HMSteve/HB-UNI-Sen-CO2_v2/PCB/SCD41_Breakout_v1_TopPlace.pdf

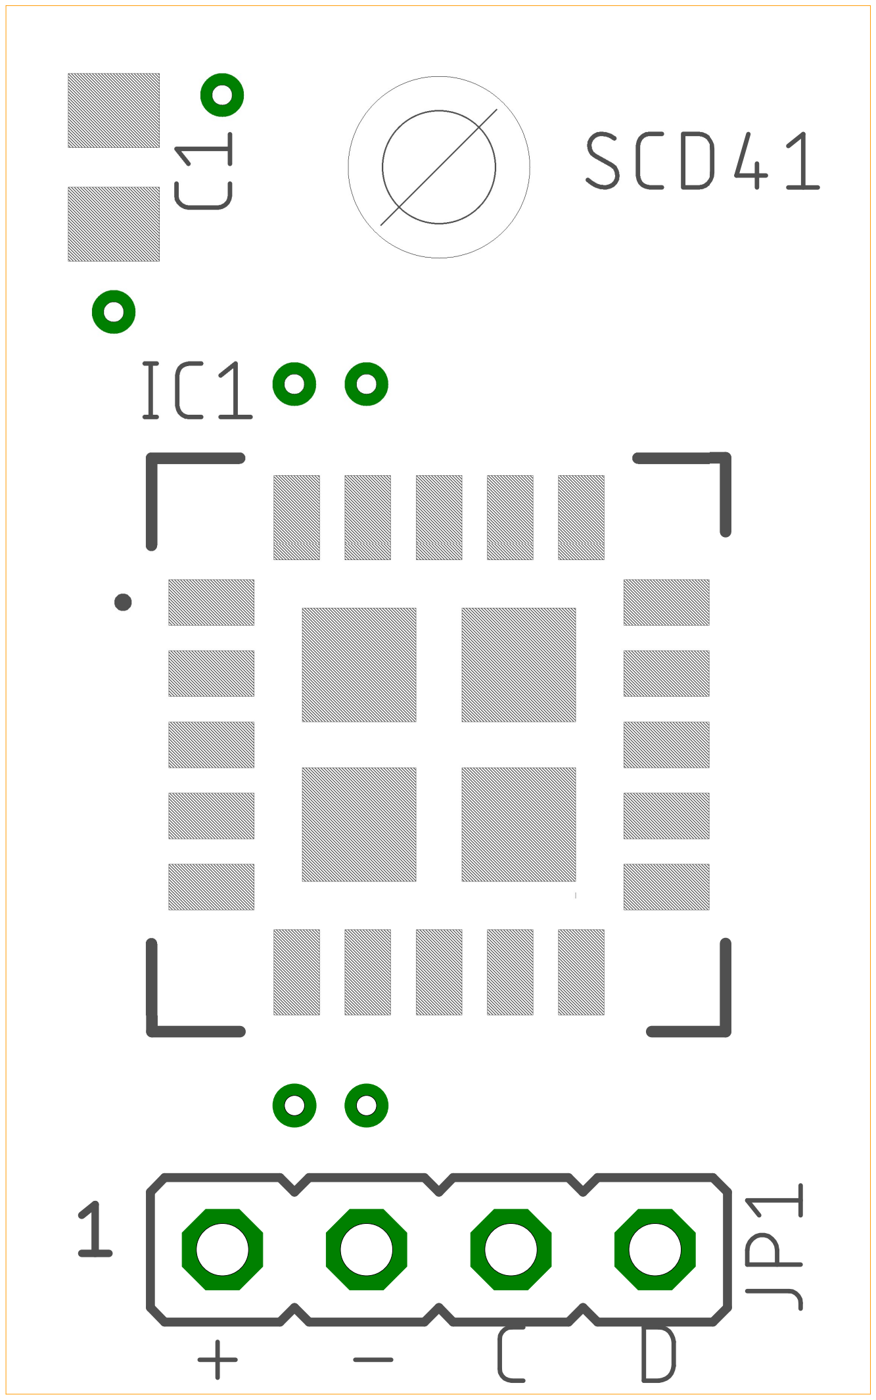
[picture p3: figure]
