HMSteve/HB-UNI-Sen-CO2_v2/PCB/HB-Uni-Sen-CO2_v2p1_Schematic.pdf

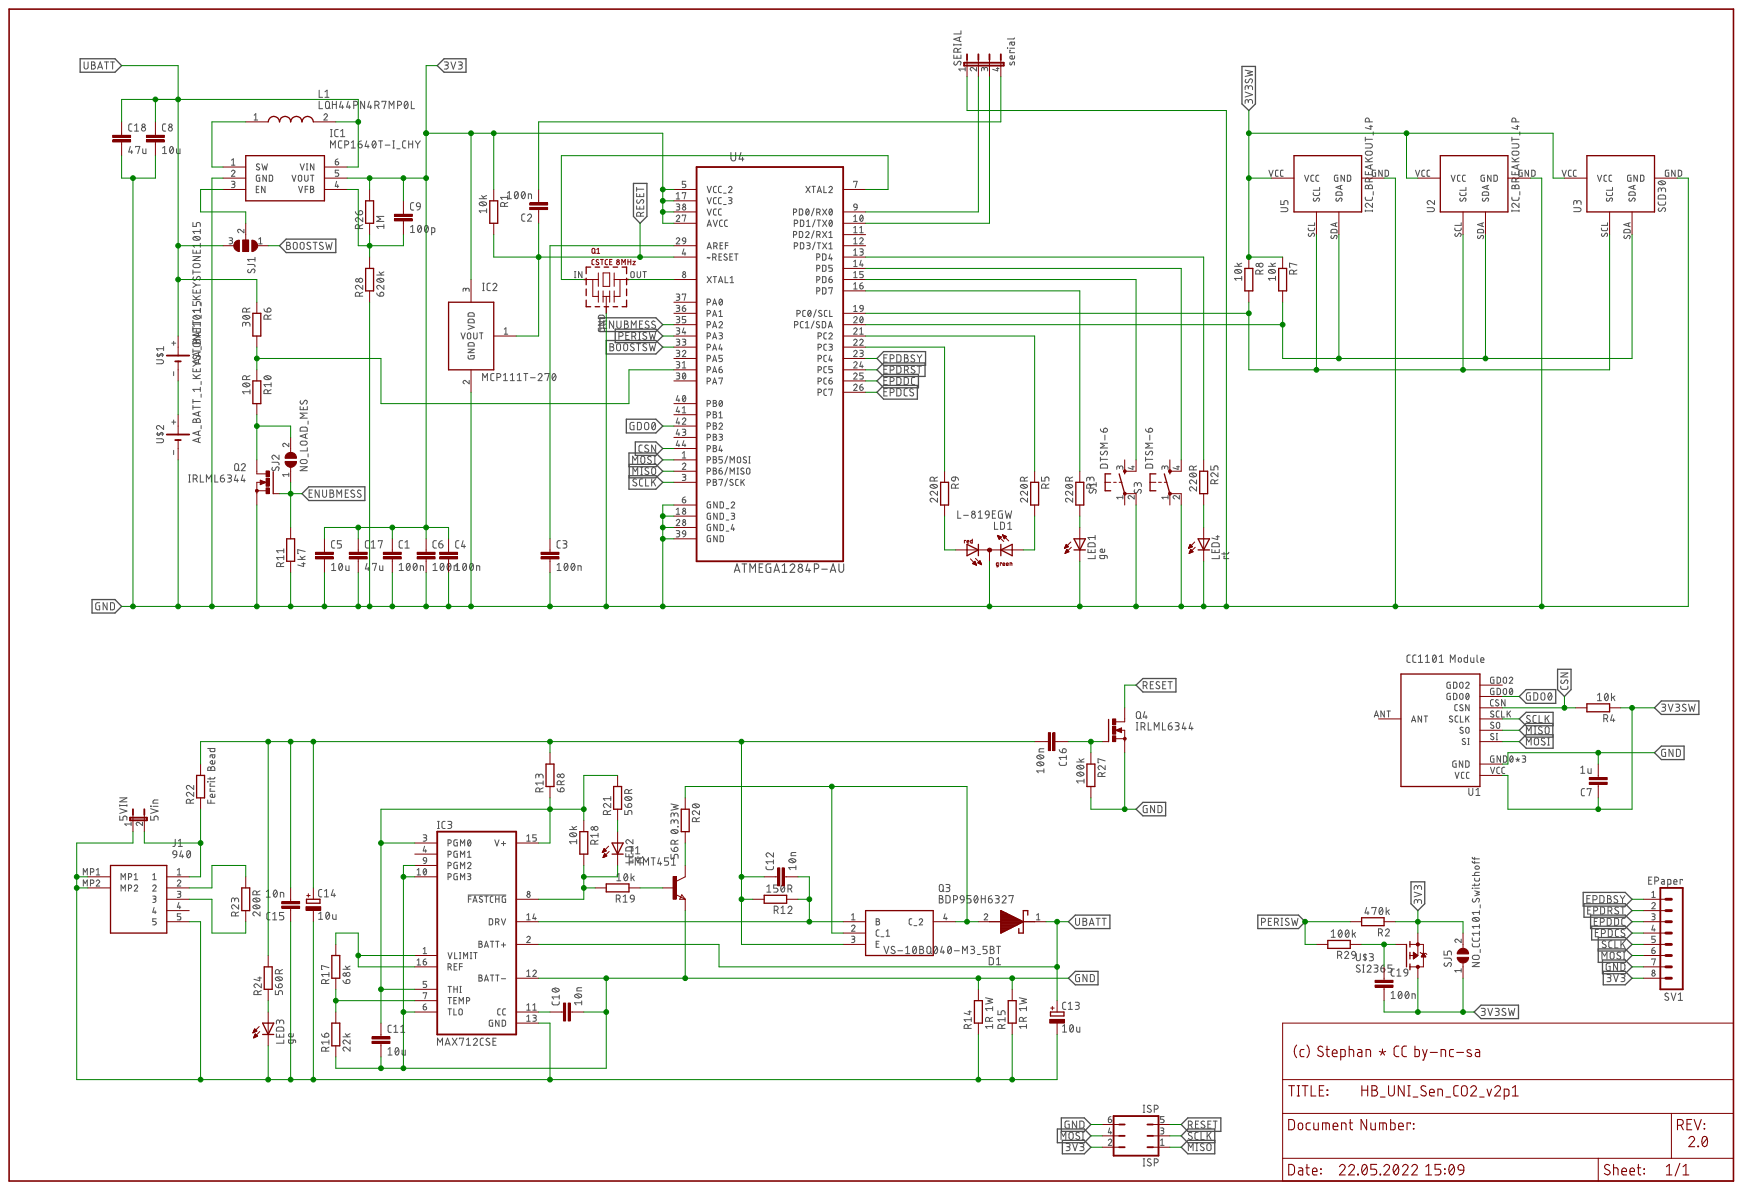
[picture p4: page 1]
