HMSteve/HB-UNI-Sen-CO2_v2/PCB/HB-Uni-Sen-CO2_v2_Schematic.pdf

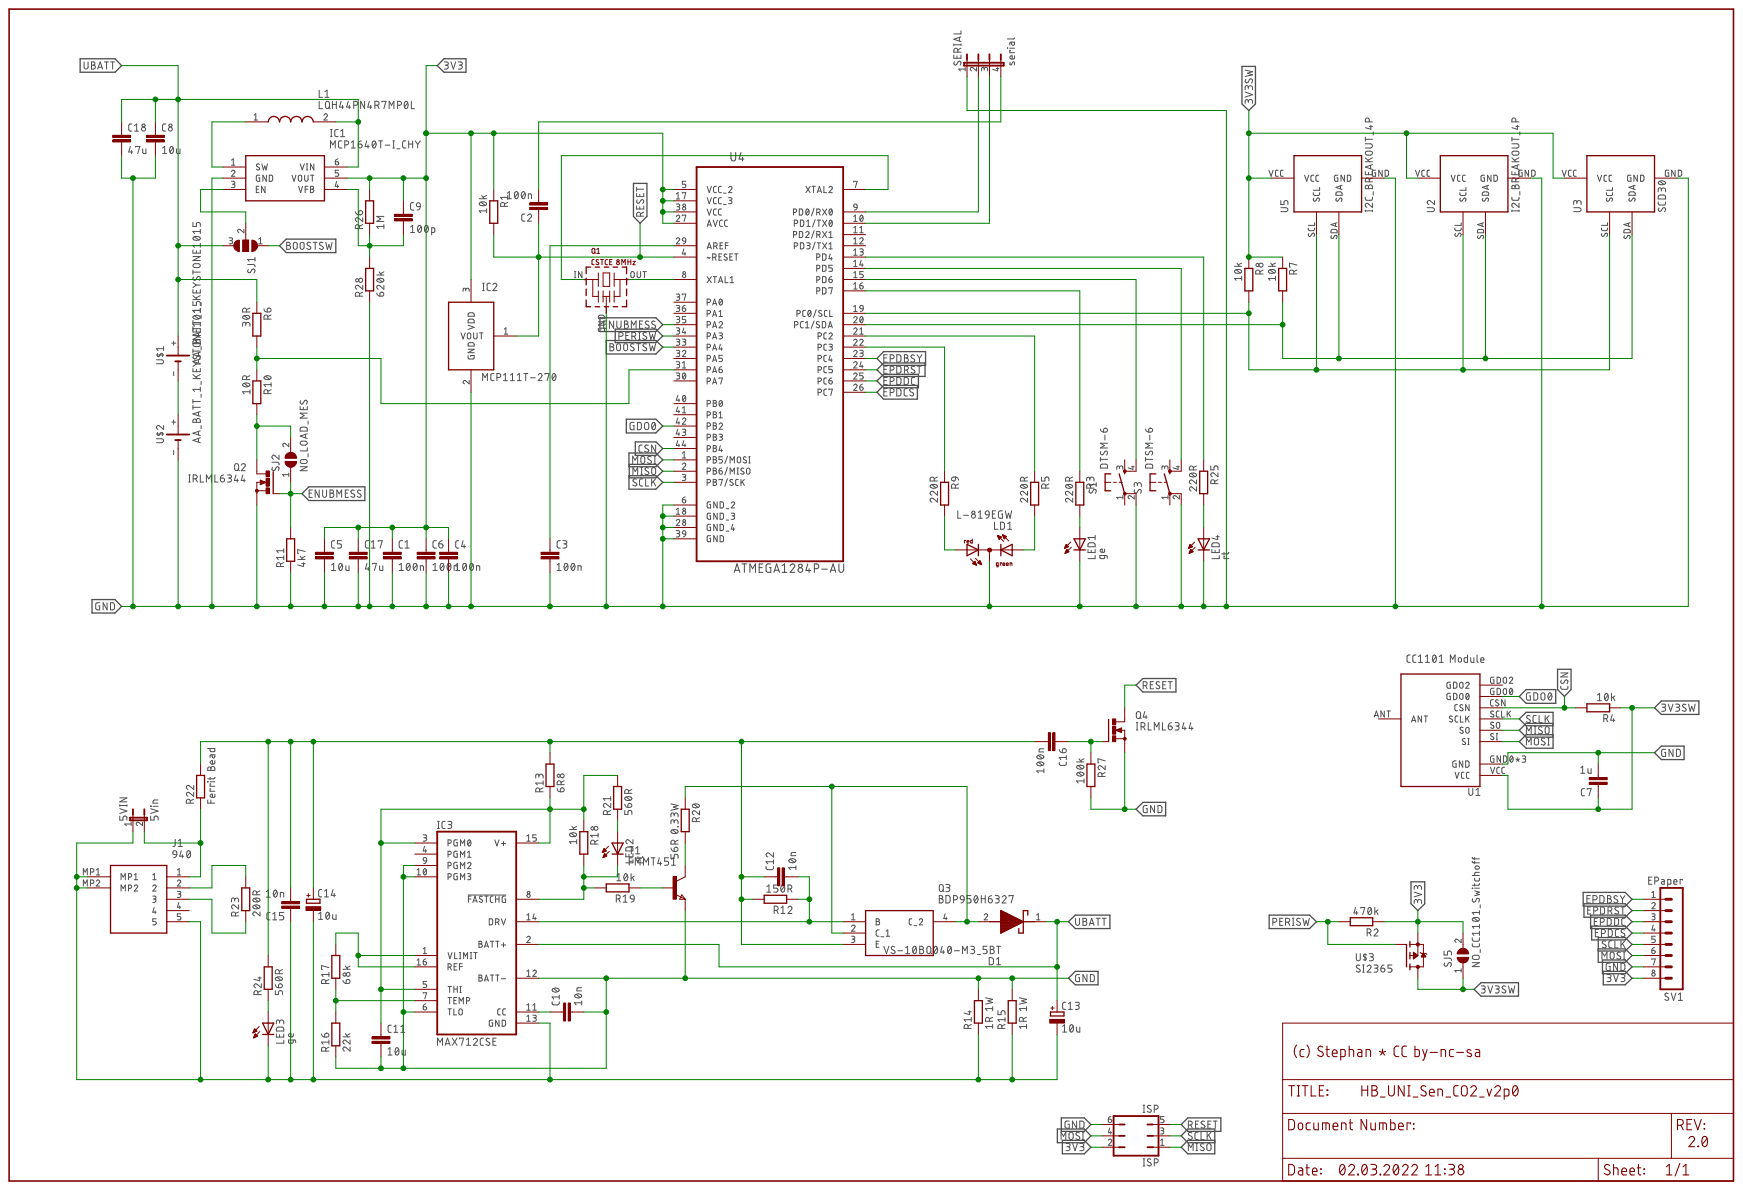
[picture p5: page 1]
