HMSteve/HB-UNI-Sen-CO2_v2/PCB/SCD41_Breakout_v1_BottomPlace.pdf

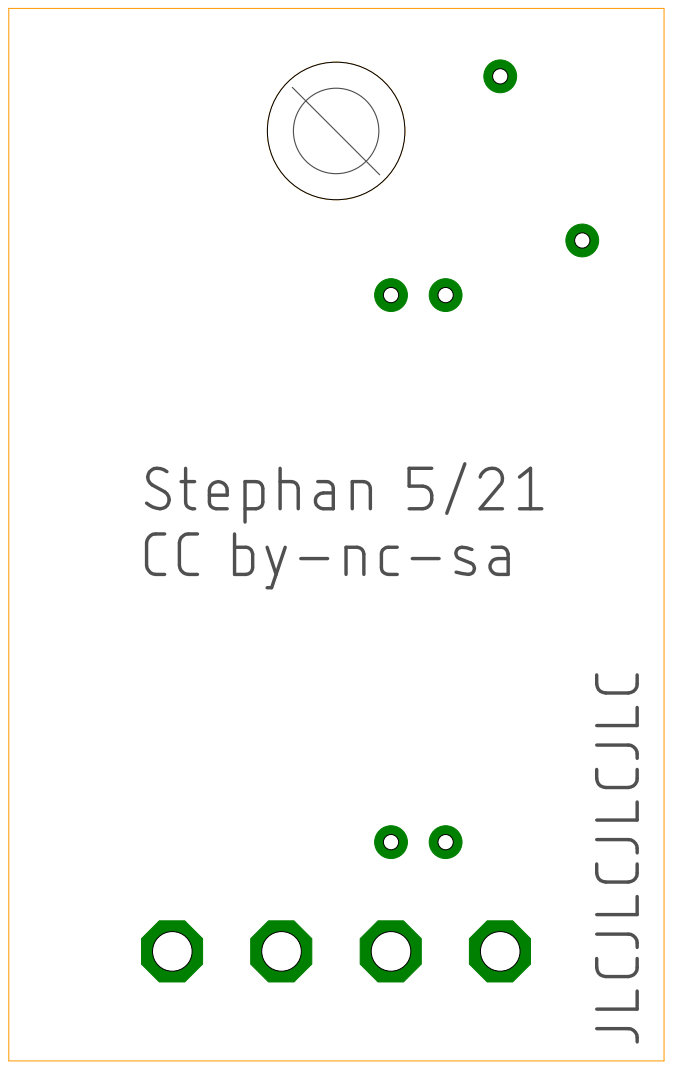
[picture p6: page 1]
