HMSteve/HB-UNI-Sen-CO2_v2/PCB/HB-Uni-Sen-CO2_v2_BottomPlace.pdf

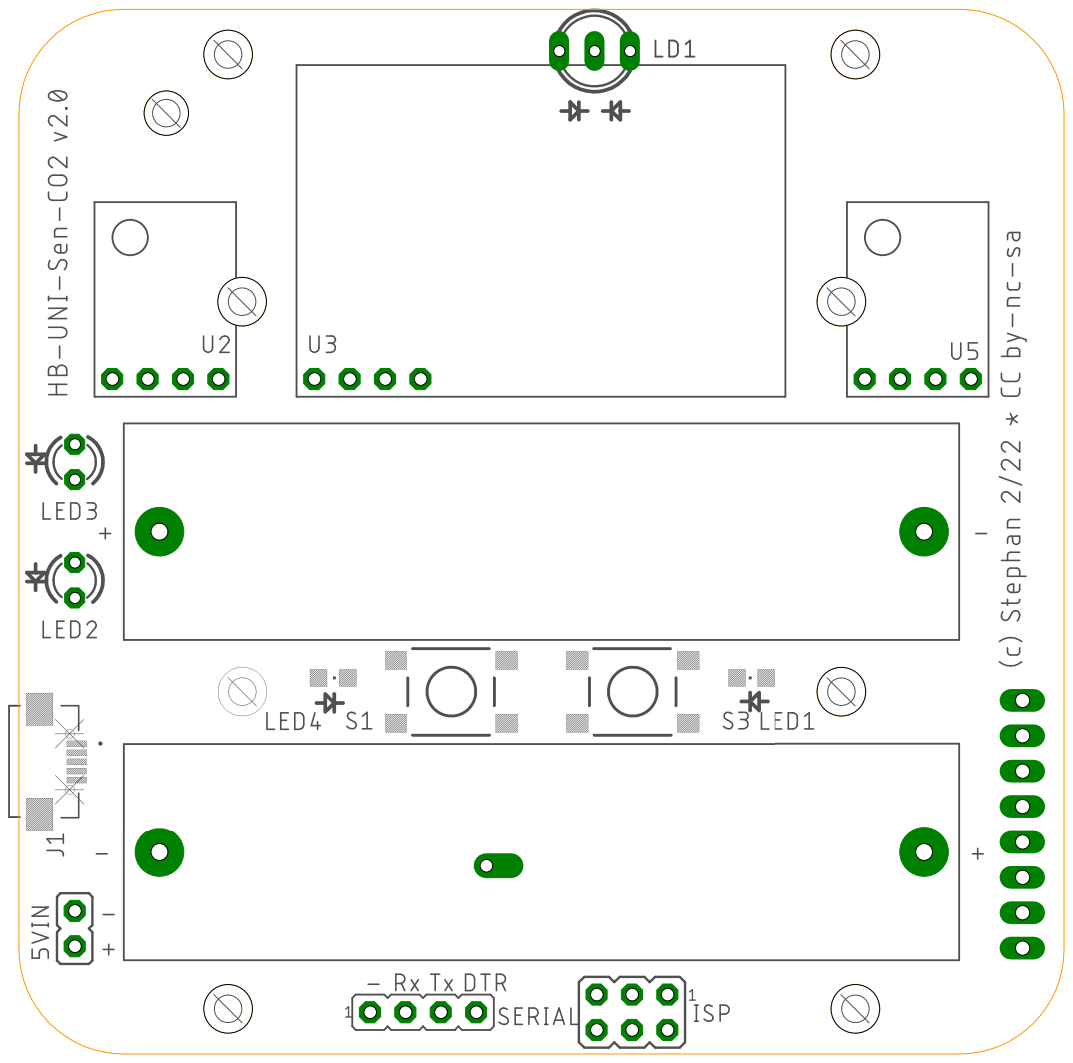
[picture p7: page 1]
