HMSteve/HB-UNI-Sen-CO2_v2/PCB/HB-Uni-Sen-CO2_v2_TopPlace.pdf

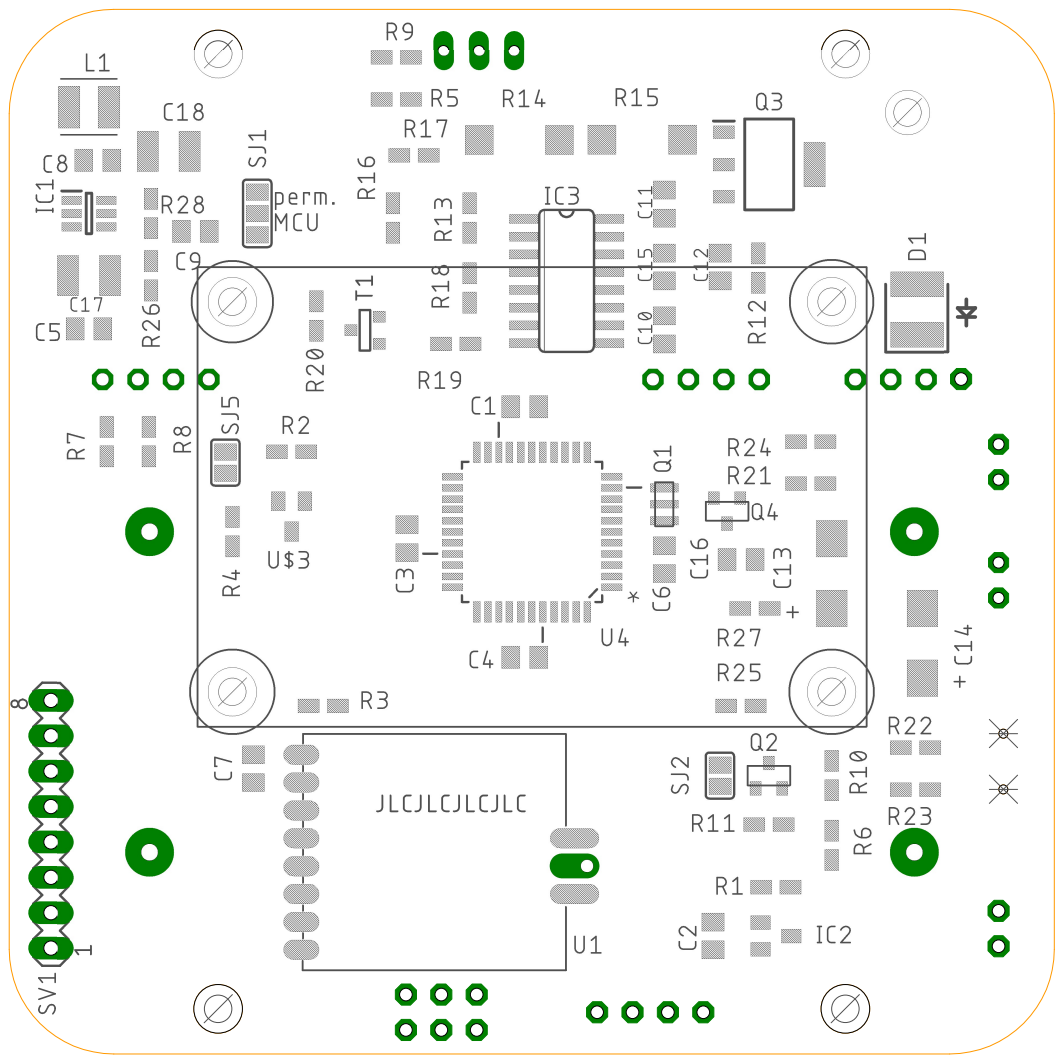
[picture p8: page 1]
