HMSteve/HB-UNI-Sen-CO2_v2/(commit log)

2022-05-22 new repo for v2
    [PowerBudgeting.xlsx]
2022-05-22 v2p1 schematic added
2022-05-22 breakout pcb added
